briansaiz/RoboticsFinalProject/assets/TumbnailVIdeoFInal.jpg

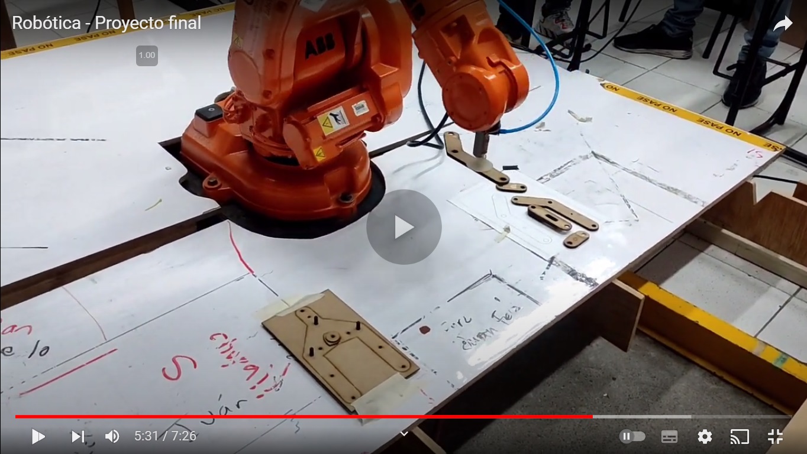
assets/TumbnailVIdeoFInal.jpg
