briansaiz/RoboticsFinalProject/Multimedia/IMG_20221116_175229.jpg

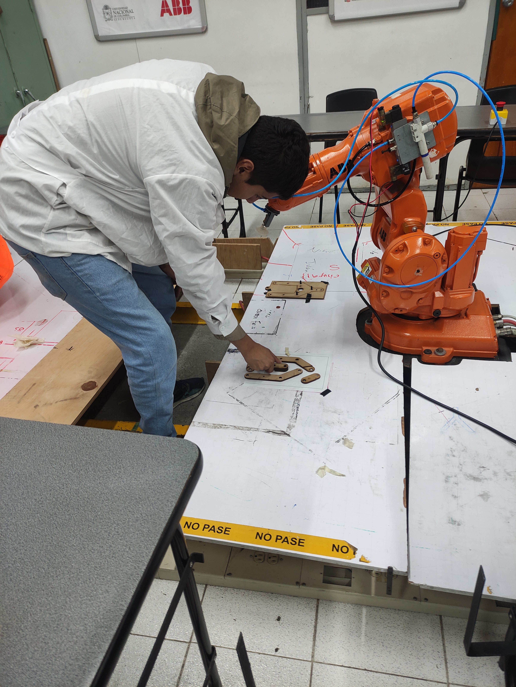
Multimedia/IMG_20221116_175229.jpg
