briansaiz/RoboticsFinalProject/Multimedia/IMG_20221116_175252.jpg

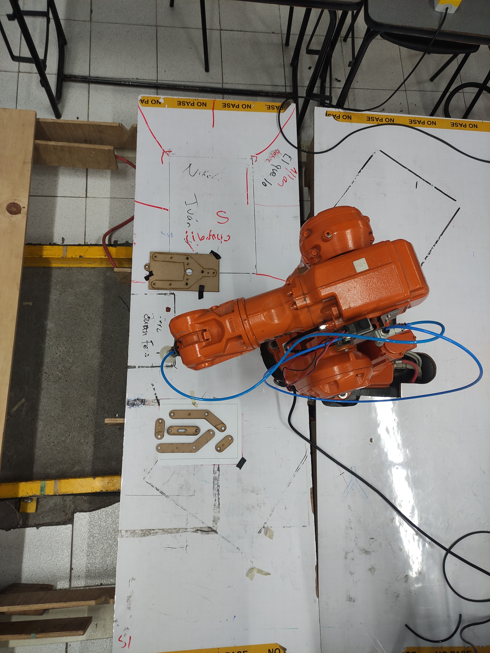
Multimedia/IMG_20221116_175252.jpg
