briansaiz/RoboticsFinalProject/Multimedia/IMG_20221116_175257.jpg

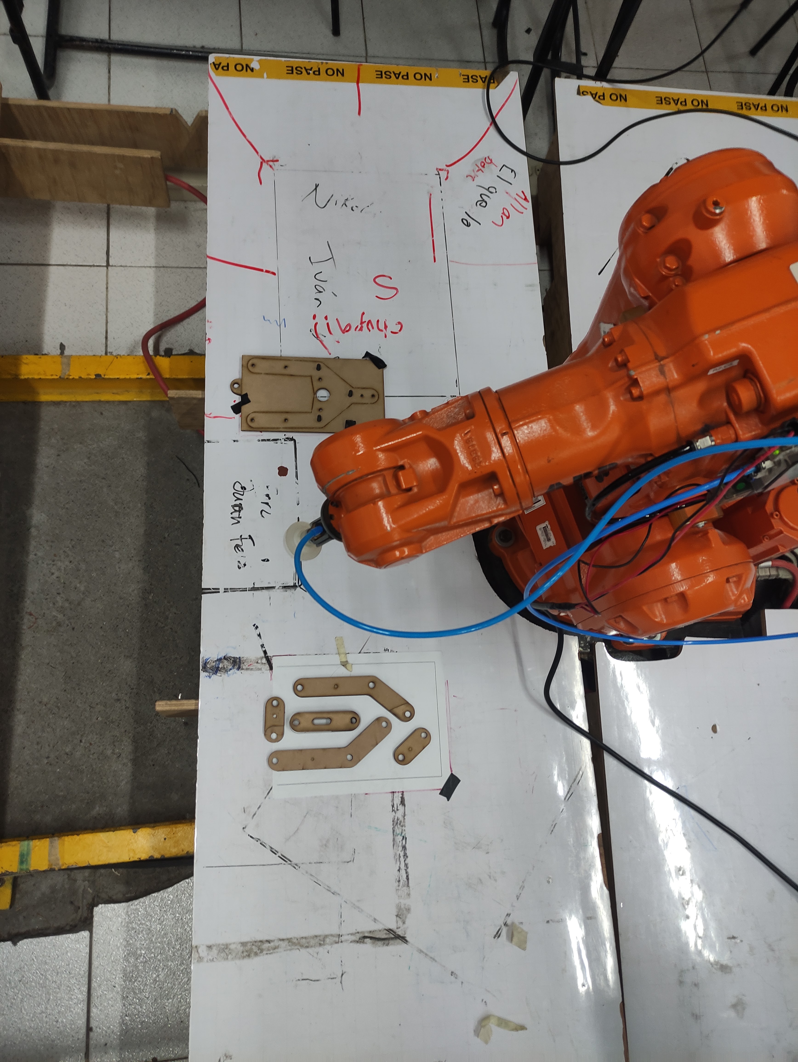
Multimedia/IMG_20221116_175257.jpg
