briansaiz/RoboticsFinalProject/Multimedia/IMG_20221116_175317.jpg

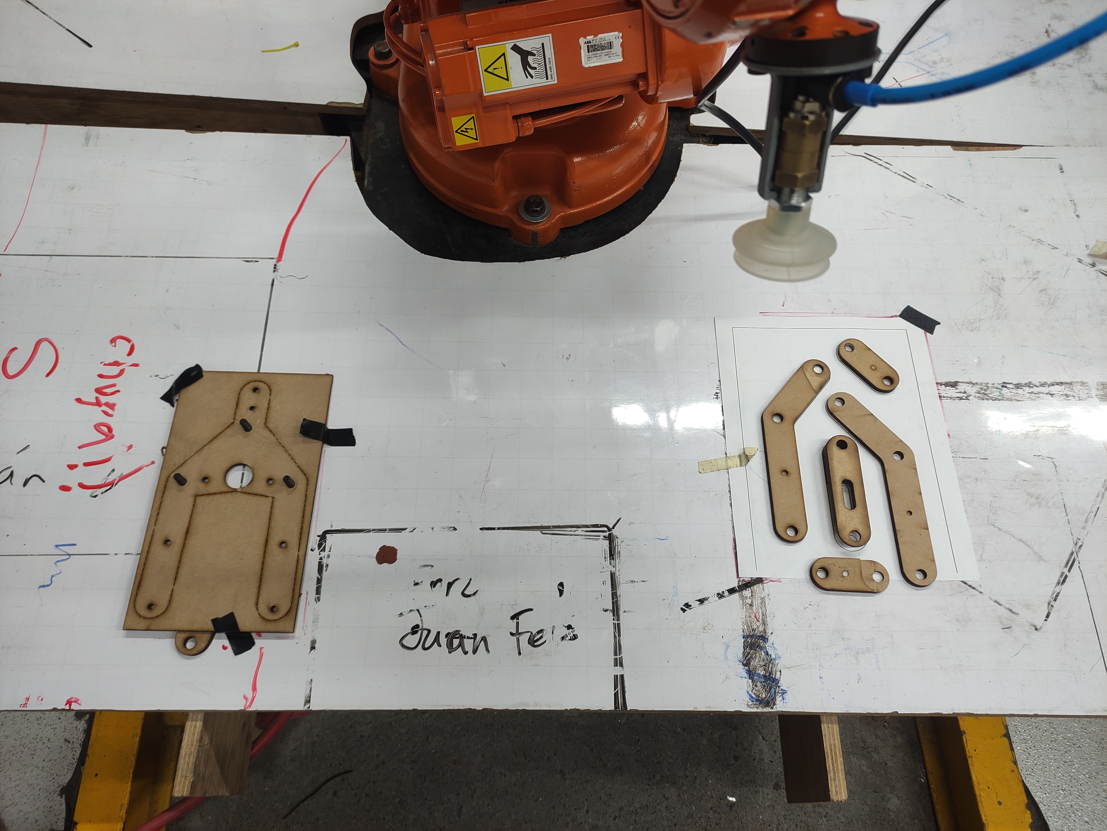
Multimedia/IMG_20221116_175317.jpg
