briansaiz/RoboticsFinalProject/Multimedia/IMG_20221116_175325.jpg

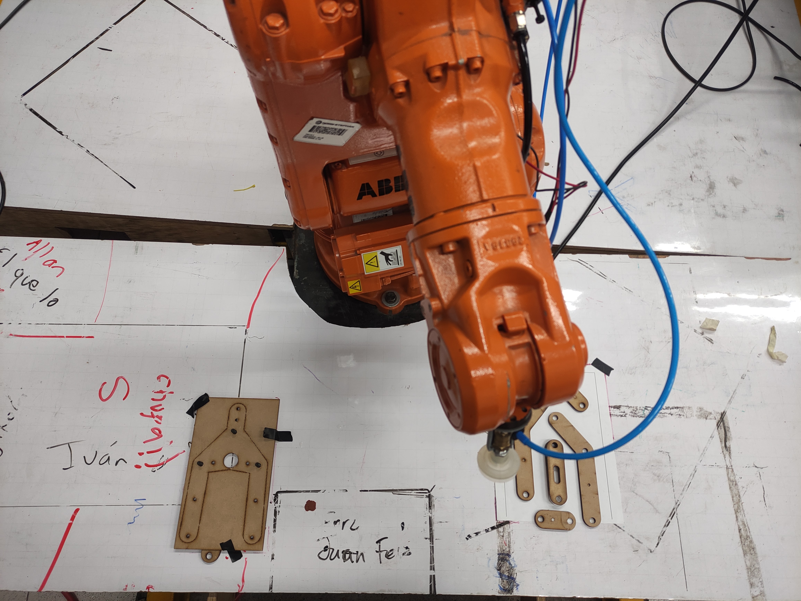
Multimedia/IMG_20221116_175325.jpg
