briansaiz/RoboticsFinalProject/Multimedia/IMG_20221116_175725.jpg

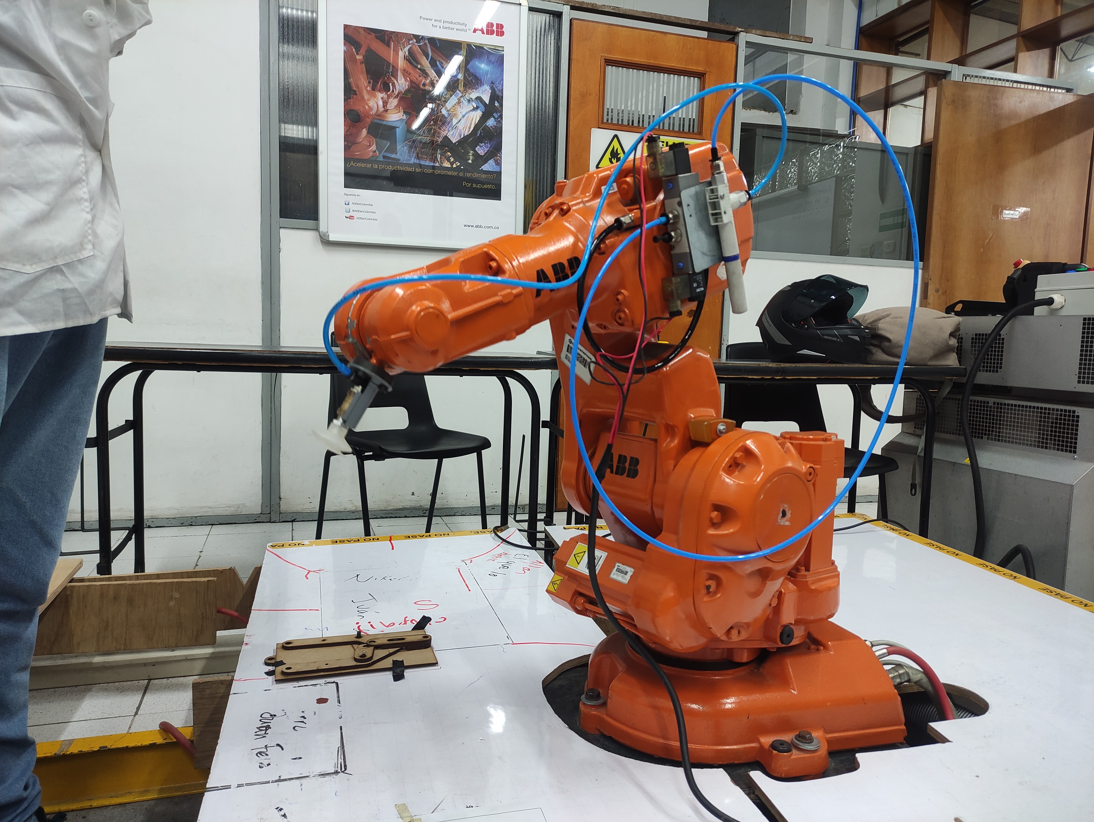
Multimedia/IMG_20221116_175725.jpg
