briansaiz/RoboticsFinalProject/Multimedia/P&P.jpeg

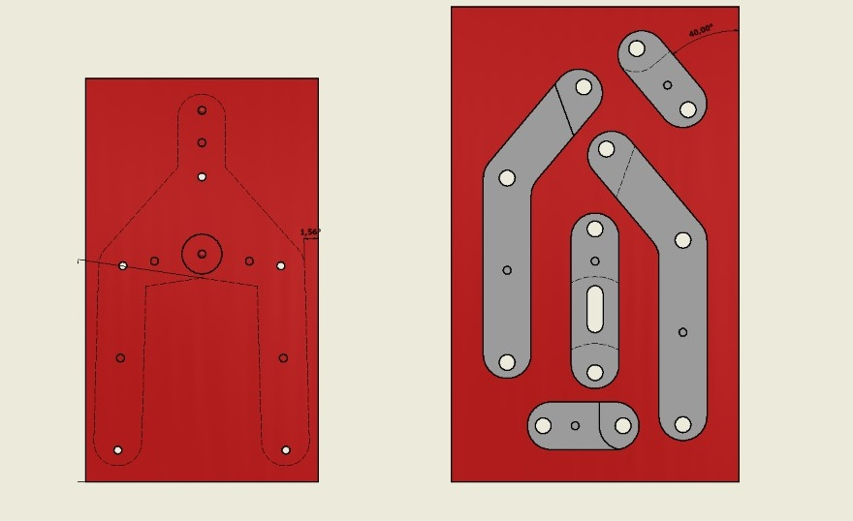
Multimedia/P&P.jpeg
