briansaiz/RoboticsFinalProject/Multimedia/WhatsApp Image 2022-11-15 at 11.09.19 PM (1).jpeg

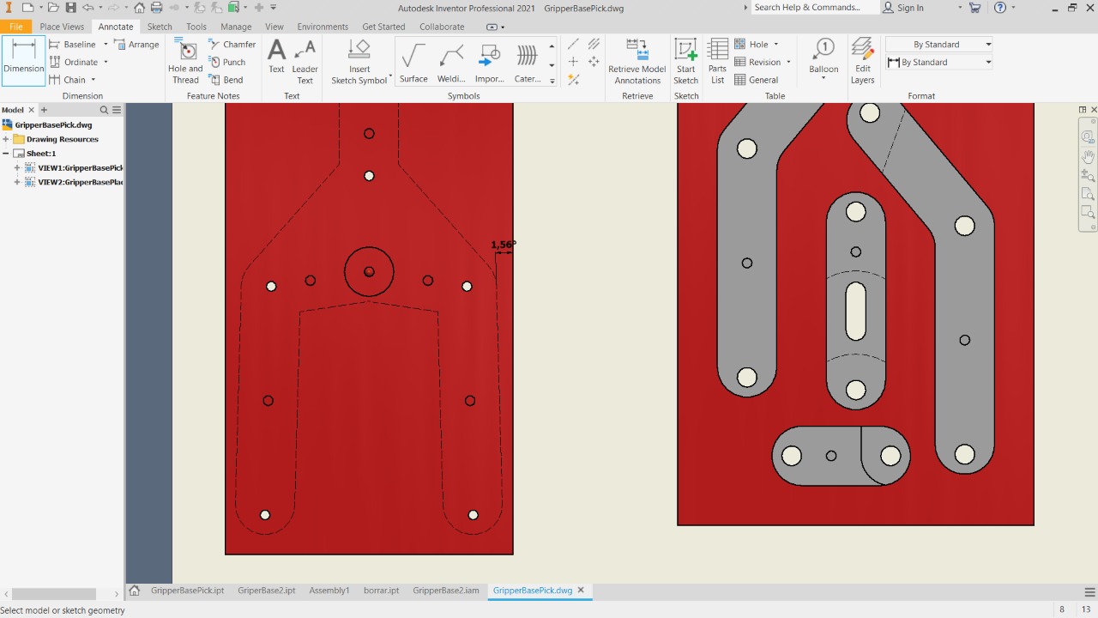
Multimedia/WhatsApp Image 2022-11-15 at 11.09.19 PM (1).jpeg
