briansaiz/RoboticsFinalProject/(list of files, cad)

Other CAD files:
3D model/Inventor/Connector.ipt
3D model/Inventor/Elbow.ipt
3D model/Inventor/GripP1.ipt
3D model/Inventor/GripP3.ipt
3D model/Inventor/GripP4.ipt
3D model/Inventor/Gripper.iam
3D model/Inventor/Gripper2.iam
3D model/Inventor/GripperBasePick.iam
3D model/Inventor/GripperBasePick.ipt
3D model/Inventor/GripperBasePlace.iam
3D model/Inventor/Tool1.ipt
