briansaiz/RoboticsFinalProject/planos/GRIPPER.pdf

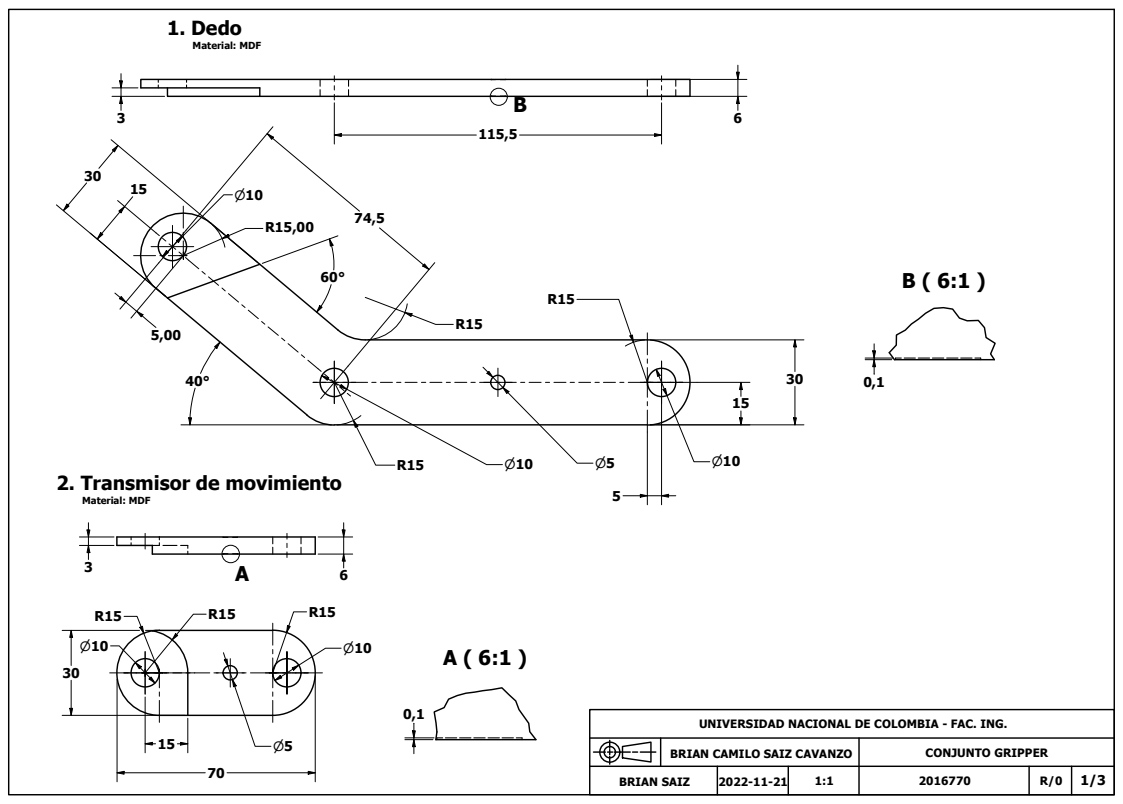
[picture p12: page 1]
1. Dedo; Material: MDF

2. Transmisor de movimiento

UNIVERSIDAD NACIONAL DE COLOMBIA - FAC. ING.

BRIAN CAMILO SAIZ CAVANZO | CONJUNTO GRIPPER

BRIAN SAIZ | 2022-11-21 | 1:1 | 2016770 | R/0 | 1/3

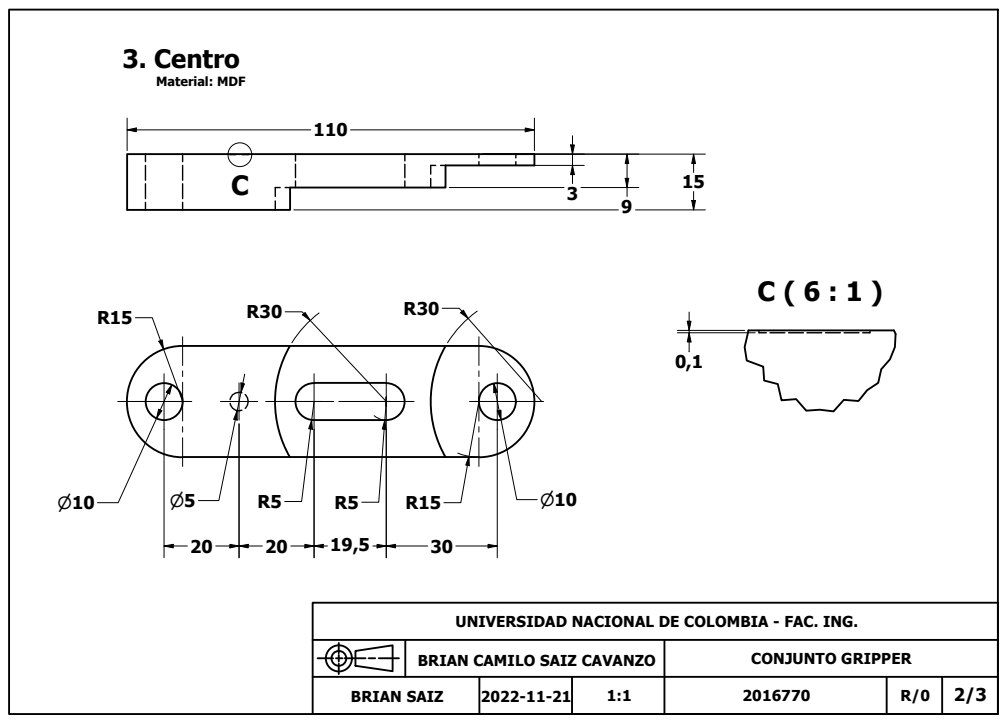
[picture p13: page 2]
3. Centro; Material: MDF

UNIVERSIDAD NACIONAL DE COLOMBIA - FAC. ING.

BRIAN CAMILO SAIZ CAVANZO | CONJUNTO GRIPPER

BRIAN SAIZ | 2022-11-21 | 1:1 | 2016770 | R/0 | 2/3

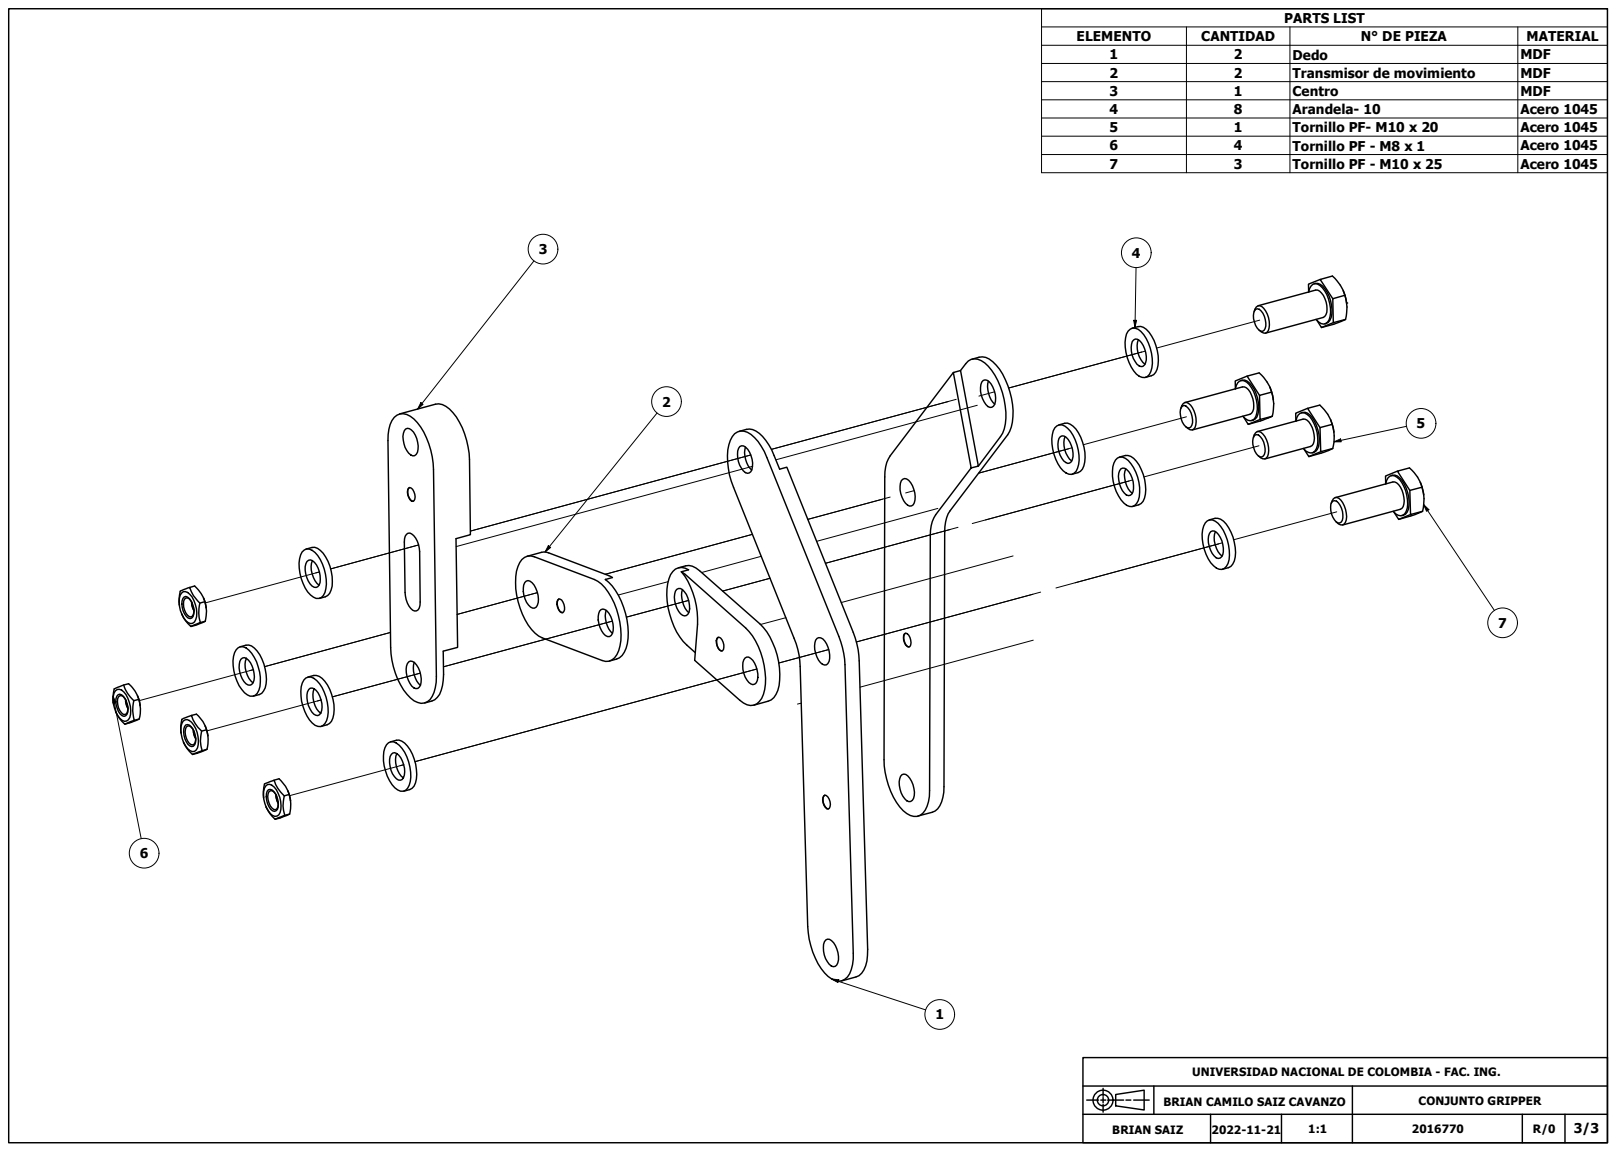
[picture p14: page 3]
PARTS LIST

ELEMENTO | CANTIDAD | N° DE PIEZA | MATERIAL
1 | 2 | Dedo | MDF
2 | 2 | Transmisor de movimiento | MDF
3 | 1 | Centro | MDF
4 | 8 | Arandela- 10 | Acero 1045
5 | 1 | Tornillo PF- M10 x 20 | Acero 1045
6 | 4 | Tornillo PF - M8 x 1 | Acero 1045
7 | 3 | Tornillo PF - M10 x 25 | Acero 1045

UNIVERSIDAD NACIONAL DE COLOMBIA - FAC. ING.

BRIAN CAMILO SAIZ CAVANZO | CONJUNTO GRIPPER

BRIAN SAIZ | 2022-11-21 | 1:1 | 2016770 | R/0 | 3/3
