briansaiz/RoboticsFinalProject/planos/Portaherramienta.pdf

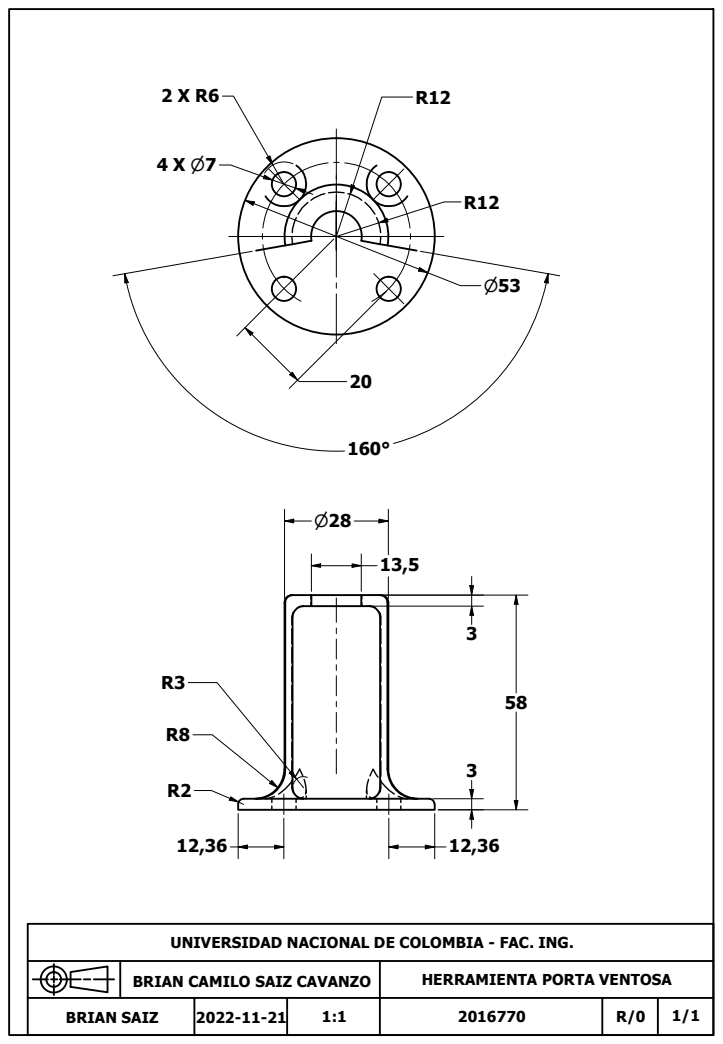
[picture p15: page 1]

UNIVERSIDAD NACIONAL DE COLOMBIA - FAC. ING.

BRIAN CAMILO SAIZ CAVANZO | HERRAMIENTA PORTA VENTOSA

BRIAN SAIZ | 2022-11-21 | 1:1 | 2016770 | R/0 | 1/1
