briansaiz/RoboticsFinalProject/(commit log)

2022-11-24 planos gripper
2022-11-25 Archivos inventro
    [Connector.ipt, Elbow.ipt, GripP1.ipt, GripP3.ipt, GripP4.ipt, Gripper.iam, Gripper2.iam, GripperBasePick.iam]
